TheJoboReal/self_watering_pot/pcb/main_board/main_board.png

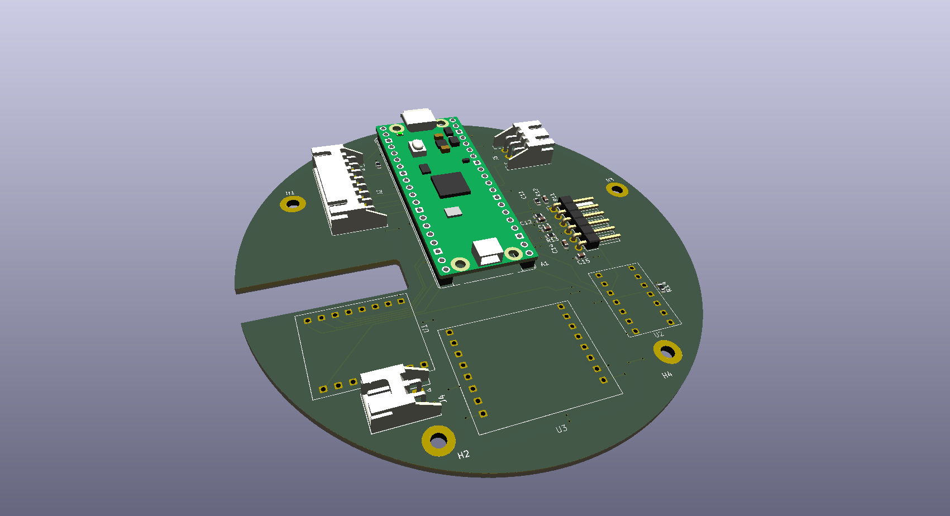
pcb/main_board/main_board.png
