TheJoboReal/self_watering_pot/report.pdf

# Low Powered Automatic Self Water Plant Pot

Kasper Bloch Mathiasen
Author
SDU
Odense, Denmark
kmath22@student.sdu.dk

Anders Stengaard
Supervisor
SDU
Odense, Denmmark
maedje@typst.app

Abstract—Maintaining plants in offices can be challenging during weekends and vacations when regular watering is not possible. This project presents the development of a low-power, low-cost automatic self-watering plant pot designed to operate for extended periods without external power. The system uses a Raspberry Pi Pico, a soil moisture sensor, a water pump, and an e-ink display. To minimize power consumption, the Pico enters dormant mode between watering cycles and is woken approximately every six hours using an external binary counter. A Run-To-Complete scheduler manages the system tasks, while a fuzzy controller is used to determine watering duration based on soil moisture measurements. The implemented components were successfully tested together on a breadboard, demonstrating the basic functionality of the system. Theoretical calculations estimate an average current consumption of 0.845 mA, corresponding to approximately three months of operation using an 1800 mAh battery. However, the estimated battery lifetime could not be experimentally verified due to damage to the battery shield during implementationMaintaining plants in offices can be challenging during weekends and vacations when regular watering is not possible. This project presents the development of a low-power, low-cost automatic self-watering plant pot designed to operate for extended periods without external power. The system uses a Raspberry Pi Pico, a soil moisture sensor, a water pump, and an e-ink display. To minimize power consumption, the Pico enters dormant mode between watering cycles and is woken approximately every six hours using an external binary counter. A Run-To-Complete scheduler manages the system tasks, while a fuzzy controller is used to determine watering duration based on soil moisture measurements. The implemented components were successfully tested together on a breadboard, demonstrating the basic functionality of the system. Theoretical calculations estimate an average current consumption of 0.845[mA], corresponding to approximately three months of operation using an 1800[mAh]. However, the estimated battery lifetime could not be experimentally verified due to damage to the battery shield during implementation. Link to the GitHub can be found here (https://github.com/TheJoboReal/self_watering_pot)

I. Introduction

We spend many hours in our offices at out workplace, this can have a negative impact on our mental health. A way to combat this is to set up plants around the office to help improve the overall mental health in that room [1]. One such plant could be a tomato plant, as it can help improve the overall mental health along with supplying a healthy snack in the form of tomatoes. However, one downside to these plants is the need to be watered daily, which can prove difficult as most office workers are not able to water them during the weekends or vacations. This could result in a work environment getting worse due to dead or rotting plants being in the office. In this individual self study project a low power, low budget self watering plant pot is developed to enable autonomous care of plants. The pot should be battery powered to ensure it is not restricted by power outlets and should be low powered and able to run without being charged for an extended period of time.

II. Related Works

Many such self watering plant pots can be bought from various online stores, such as this growing system [2] that needs to be plugged into the wall, or this more expensive smart plant pot [3] that has an integrated temperature sensor and moisture sensor. The Smart Pot does not state the battery life but is most likely not multiple months. There also exists many mechanical(passive) self watering plant pots, but many share the same limitation: The roots are constantly moist which restricts oxygen and can lead to root rot[4], while some watering systems transport water too slowly for some plants, such as tomatoes[5].
To address some of these limitations, this project focuses on developing a low-power, battery-operated self-watering system that uses soil moisture measurements to control the amount of water supplied to the plant. This allows watering to be adjusted based on the measured soil conditions while aiming to maintain a long battery life.

III. Methods

To ensure long battery life, low powered components are used in the pot. The main component of the pot is a Pico Pi running a Run-To-Complete scheduler and using dormant mode to ensure a low as possible power draw when the system is idling [6]. Thus the components used should be low power and low budget off the shelves components.

A. Components

The components used in this project is:
- HW-101 HW-moisture sensor V1.2.
- SC3101PW Vacuum diaphragm pump 3V [7].
- Binary Counter [8].
- Pico Pi 2W.
- Rechargeable Lithium Battery 1800[mAh].
- Battery Shield Wemos D1 mini.
- Motor Driver TB6612FNG.
- SD card module(planned, not integrated in hand in prototype).
- Eink Display 2.9 waveshare.

In order to use the pico pi in dormant mode an external wakeup call is needed, as the dormant mode disable the pico’s internal clock, making it unable to wake it self. To overcome this, a binary counter is used, as with the correct resistor and capacitance used with it results in the output signal going high approximately every 6 hours. This signal will then be used as the external wakeup signal for the pico pi. To avoid the counter staying high for 6 hours as well, the pico resets the counter before going to deep sleep again. This will allow the pico to draw 0.8[mA] [6] as it enters dormant mode. The pump used is a cheap 3[V] vacuum pump that draws 65[mA] to 170[mA] and will be driven with a TB6612FNG motor controller. With the pump running only at very short bursts, this should fit well in the project.
A 1800[mAh] rechargeable lithium battery is used together with a battery shield to allow for easy charging using a micro USB cable.
To enable some sort of user interface an Eink display is used to display moisture, and watering time. Eink displays are a perfect fit for this type of project as they only use power when updating the display, after which they use no power yet still show the same image.
B. Software

The software for the Pico Pi is written in C to ensure the program runs efficient when the Pico is awake. The software is build around a simple Run To Complete(RTC) scheduler to make developing modular and accessible. The functionality of the pot is divided into tasks as seen in Fig. 1. The first task after wakeup is to measure the moisture in the soil and write the result to the soil struct. The software is designed to support logging moisture measurements and watering amounts to an SD card. However, this functionality was not implemented in the final prototype due to a missing connector on the PCB and is therefore left for future development. After reading the moisture sensor output the value is inserted into a simple membership function to determine the linguistic value for the linguistic variable moisture. This is inserted into a fuzzy rule set to determine the value for watering time. Using this watering time value, the pump runs for the given amount of time. The final task before dormant mode is updating the Eink display with moisture level and watering amount.

Power on / Wake up

Initialize hardware

Initialize scheduler

Run scheduled tasks

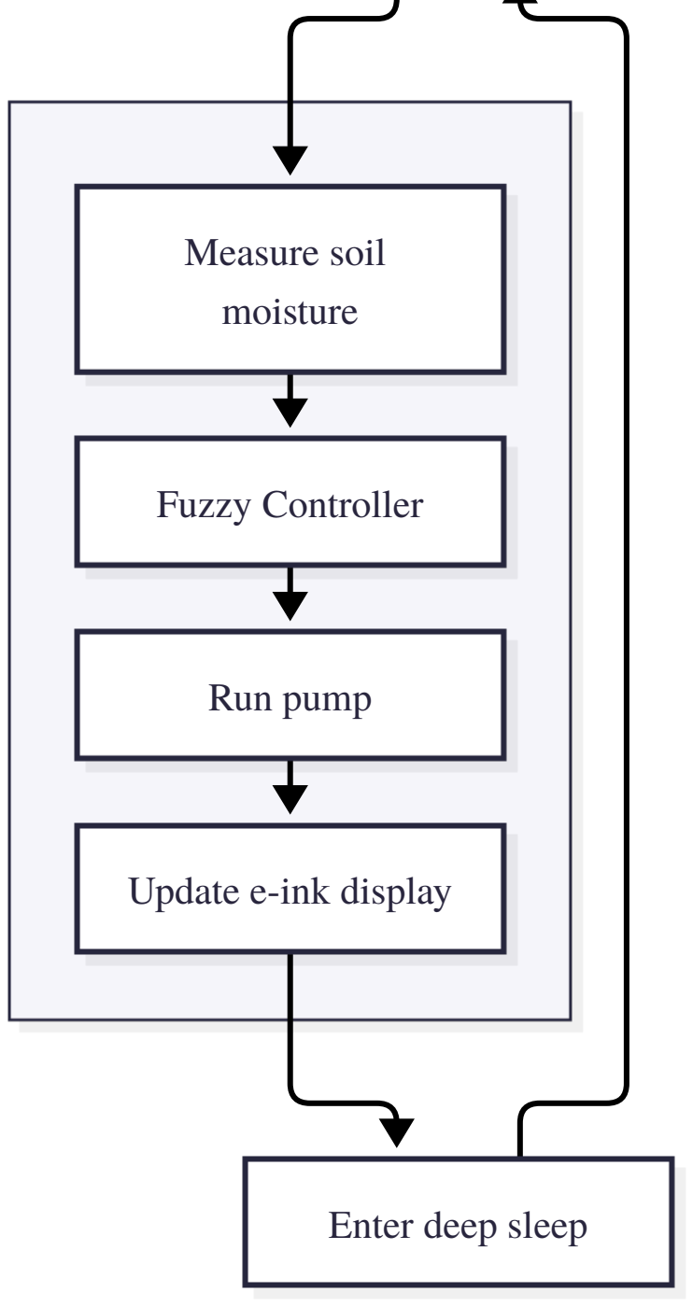
[picture p2: figure]
Measure soil; moisture; Fuzzy Controller; Run pump; Update e-ink display; Enter deep sleep

Fig. 1. Software Diagram

IV. Hardware

A. PCB Design

A PCB was designed in KiCAD to house all the components. The PCB design was sent to Aisler for manufacturing and was then soldered manually after receiving it. Small mistakes where made on the pcb design: Forgetting to route a wire for on/off for the moisture sensor, using the wrong footprint for the 4060E and forgetting to add a connector for an sd card. Though these mistakes did not invalidate the whole pcb. The 3D design can be seen in Fig. 2.

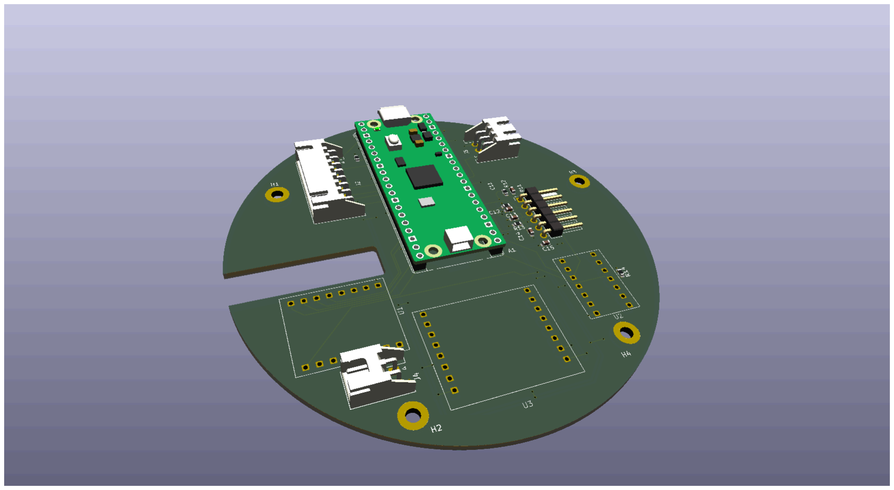
[picture p3: figure]

Fig. 2. PCB Design

B. Dormant Mode
To ensure the pi sleeps for close to 6 hours, the 4060E is used as an external wake up signal. The oscillating frequency is determined by:
1
2.2RC =

1
2.2⋅1.2[Mω]⋅1[[μF]) = 0.38[Hz]
And using output Q14 gives a frequency of: Q14 =

0.38
16384 = 0.000023[Hz]
This gives approximately a 12 hour cycle, though it should be mentioned that the 1.2[Mω] resistor is outside the specified resistance range of the 4060E, so the 6 hour low time will not be accurate.
C. Battery Life
a) 4060E:
The dynamic power consumption is determined by the formula from the datasheet[8]:
PD = CPD ⋅ V

2

CCfi + ∑(CLV
2
CC

fi
M )
where M = 2

1
, 2

2
, 2

3…2

14
a, fi =input frequency, CL = output load capacitance.
Inserting the values from our circuit:
CL = 1[pF], R = 1.2[Mω], C = 1[μ F], CPD = 40[pF], VCC = 3.3[V].
With a frequency of 0.38[Hz] and the output load of the pico pin is omitted in the dynamic formula:
40[pF] ⋅ (3.3[V])

2
⋅ 0.38[Hz] = 0.166[nW]
Thus the power draw of the 4060E when adding static and dynamic current draw is approximately 0.166[nW]
3.3[V] =
0.050[nA] + 8[μ A] ≈ 8[μ A]
b) Pump and Controller:
The max standby input current of the motor controller is rated at 1[μ A].

The pump max operating current draw is rated at 170[mA] [7]. In a test setup the pump was measured to draw approximately 100[mA] under light load. Thus 100[mA] will be used as a mean throughout the calculations.
c) Moisture sensor:
The rated operating current of the moisture sensor is 5[mA] [9]. The sensor will be turned of while in dormant mode as it is not necessary to be active while during that period.
d) Eink Display:
The eink display draws 26.4[mW]
3.3[V] ≈ 8[mA] when refreshing over 3 seconds and ≈ 0.01[μA] on standby [10].
e) Pico Pi:
The mean dormant current draw of the pico pi is 0.8[mA] according to the datasheet [6].
f) Dormant Current Draw:
Adding the standby/dormant currents up to get the total current draw when dormant:
8[μ A] + 1[μ A] + 0.01[μ A] + 0.8[mA] = 0.809[mA]. Thus a total dormant current draw of 0.809[mA] during dormant mode.
g) Active Current Draw:
Once active the pump phase draws:
IPump Phase = IPump + IPico + I4060 = 100[mA] +
25[mA] + 8[μ A] ≈ 125.008[mA]
For a maximum of 5 seconds, resulting in a maximum per pump current draw of:
QMotor Phase = 125.008[mA] ⋅

5
3600 = 0.17362[mAh]
With the moisture sensor running 2 seconds: QSensor Phase = (5[mA] + 25[mA] + 8[μ Al]) ⋅

2
3600 ≈
0.01667[mAh]
The eink refreshes for 3 seconds drawing 26.4[mW]
3.3[V] = 8[mA]
resulting in a current draw of:
QEink Pase = (8[mA] + 25[mA] + 8[μ A]) ⋅

3
3600 =
0.02751[mAh]
The phases are separated as each phase is implemented in software as a task, all running consecutively. Thus, adding all the active phases together:
Qactive = QMotor Phase + QSensor Phase + QEink Phase =
0.17362[mAh] + 0.01667[mAh] + 0.02751[mAh] = 0.21780[mAh]
h) Total Current Draw:
A full cycle of 6 hours dormant and one active cycle of 10 seconds totals the current draw at:
Dormant period without active time: tdormant = 21600[s] − 10[s] = 21590[s]
Assumed dormant current becomes:
0.80901[mA] ⋅

21590[s]
3600[s] = 4.85181[mAh]
Adding the active current draw:
4.85181[mAh] + 0.21780[mAh] = 5.06961[mAh] Meaning a full 6 hour cycle draws 5.06961[mAh]
This means that the estimated total currant draw is:
5.06961[mAh]
6[h] = 0.84494[mA], this can be seen illustrated in Fig. 3.

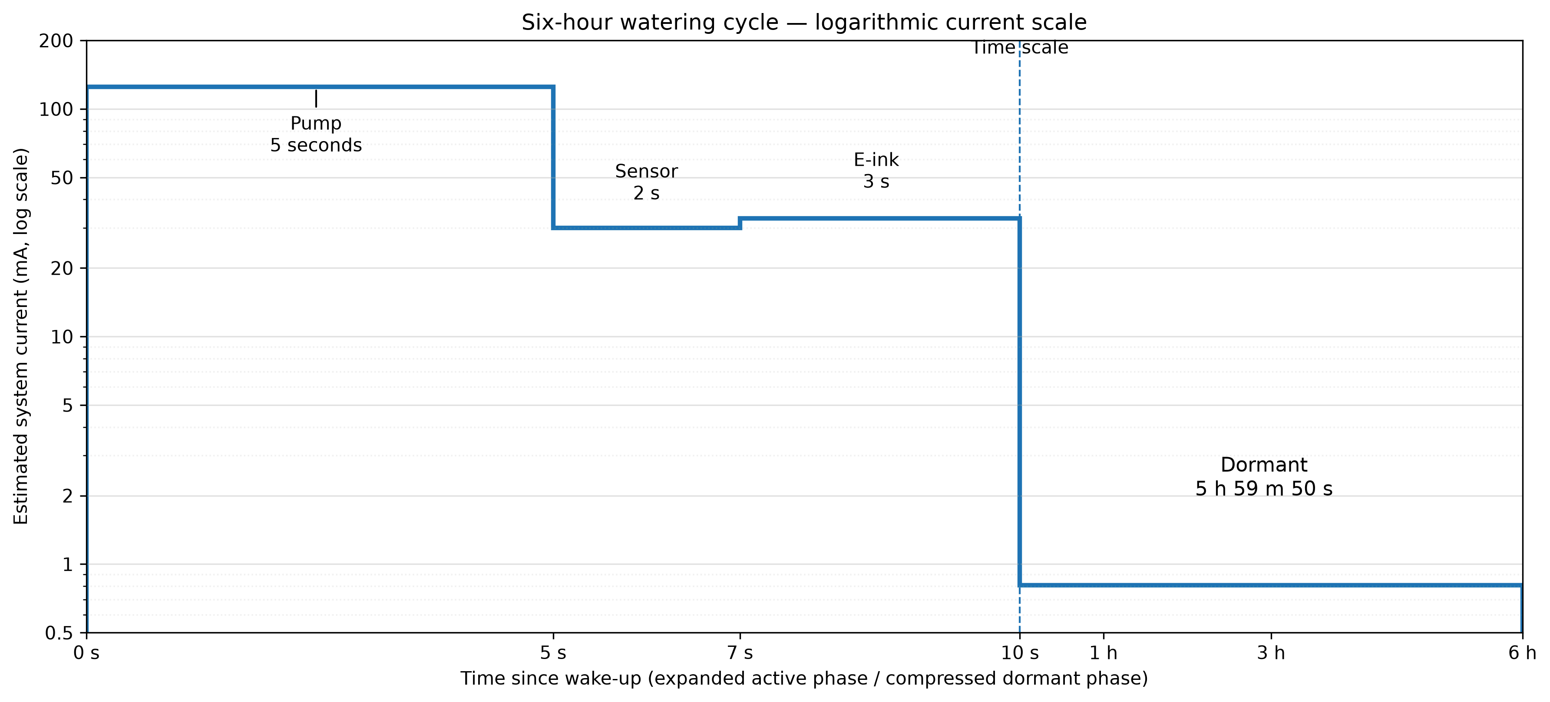
[picture p4: figure]

Fig. 3. Estimated Current Consumption

Meaning that the total battery life will be:
1800[mAh]
0.84494[mA] = 2130[h]
or:
2130[h]
24

30 = 2.96[months]. Note that this is a theoretical optimistic estimate and based on numbers from the data sheets.

V. Test

To determine if the estimated power consumption is correct the circuit will be tested by connecting the battery shield to a power supply with a multimeter in series in between. With this configuration the total current draw of both dormant and active mode can be read on the multimeter. Unfortunately the battery shield was damaged during implementation and can no longer be used, thus the test could not be performed in time for the project hand in.
All components was however tested in a breadboard and proved the functionality of the whole system.

VI. Results

All components worked during testing in a breadboard and showed all the components working as expected in unison. The estimated battery life is 3 months derived from the calculated total current draw of 0.85[mA] on a 1800[mAh] lithium battery. Real life measurements was not done in time as the battery shield was damaged when implementation the components in the pcb, hindering the real life tests.

VII. Learning Achievements

A. PCB Design

In this project i designed, ordered and soldered my first PCB. The pcb was manufactured professionally by the company Aisler. The pcb was functioning correctly but had some mistakes such as forgetting to implement a connector for an SD card and routing a wire for on/off for the moisture sensor. Though these mistakes will be fixed in the GitHub repo.

B. Low Power Embedded Projects

Through this project i went through the full pipeline of creating a low powered embedded system. Starting out was choosing the right components that fit the low powered criteria, such as using an eink display for UI and a 4060E for a low powered wake signal. Another challenge that was overcome was to fit all the components together in software and creating a simple efficient control loop.

C. Mistakes

The ordered battery shield module has outputs 5V, GND and 3.3V, but it seems that the module was damaged during implementation and now outputs 10V on the 5V pin and 0V on the 3.3V pin. This is likely due to a short circuit when inverting the encoder poles to ensure the encoder switch is active HIGH and not active LOW.

VIII. Future Work

The project will be made public on GitHub and will continue to be updated and improved upon. Firstly, the mistakes made on the hardware will be fixed and a new PCB will be designed to correct the footprint mistakes. A new battery shield will be ordered to replace the broken one.
After the errors has been fixed, a fuel gage will be added to measure the battery percentage which will be displayed on the eink display. An SD card module will also be added to enable logging during operation and can enable plotting of various data on the eink display.

IX. Conclusion

In this project, a low-power automatic self-watering plant pot was developed using a Raspberry Pi Pico, a soil moisture sensor, a water pump, and an e-ink display. To reduce power consumption, the Pico uses dormant mode together with an external binary counter to wake the system approximately every six hours. The software was developed using a simple Run-To-Complete scheduler to manage the different tasks of the system.
The implemented components was successfully tested together on a breadboard, demonstrating the basic functionality of the self-watering system. Based on theoretical calculations using component datasheets, the system has an estimated average current consumption of 0.845[mA], resulting in a battery life of approximately three months with an 1800[mAh] battery. However, this estimate could not be verified through physical measurements due to damage to the battery shield during implementation.
Although the project encountered some hardware design mistakes, it provided valuable experience in designing PCBs, selecting low-power components, and developing embedded software. Further improvements are needed before the system can be considered fully completed, including correcting the PCB design, implementing SD card logging, and verifying the actual power consumption.
X. Acknowlegdement

LLM’s was used in the process or correcting the report. The plant pot CAD design is derived from the work of Martin [11].

References

[1] C. Hall and M. Knuth, “An update of the literature supporting the wellbeing benefits of plants: A review of the emotional and mental health benefits of plants,” Journal of Environmental Horticulture, vol. 37, no. 1, pp. 30–38, 2019.
[2] “Indoor Garden Hydroponics Growing System,” [Online]. Available: https://www.amazon.com/Indoor-Garden-Hydroponic-Growing-System/dp/B0B6BB4TVC (https://www.amazon.com/Indoor-Garden-Hydroponic-Growing-System/dp/B0B6BB4TVC)
[3] | “Pink | Smart | Plant | Pot | with | SelfWatering | Planter,” | [On-
line]. Available: https://www.fruugo.dk/lyserod-smart-plantepotte-medselvvandende-plantepotte-fugtighedssensor-og-temperaturovervagning-til-indendorsbrug/p-452581288-954266539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 MMXDA (https://www.fruugo.dk/lyserod-smart-plantepotte-med-selvvandende-plantepotte-fugtighedssensor-og-temperaturovervagning-til-indendorsbrug/p-452581288-954266539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)
[4] | “Root Rot,” [Online]. | Available: https://extension.wsu.edu/pnw-
gardeners-handbook/chapter-14-houseplants/ (https://extension.wsu.edu/pnw-gardeners-handbook/chapter-14-houseplants/)
[5] “A Semi-Systematic Review of Capillary Irrigation,” [Online]. Available: https://www.mdpi.com/2311-7524/4/3/23
[6] “Pico Pi dormant mode++: Pico pi documentation,” [Online]. Available: https://pip-assets.raspberrypi.com/categories/610-raspberrypi-pico/documents/RP-008307-DS-2-pico-datasheet.pdf (https://pip-assets.raspberrypi.com/categories/610-raspberry-pi-pico/documents/RP-008307-DS-2-pico-datasheet.pdf)
[7] “Vacum pump,” [Online]. Available: https://www.laskakit.cz/en/sc3101pw-vakuove-membranove-cerpadlo-3v/ (https://www.laskakit.cz/en/sc3101pw-vakuove-membranove-cerpadlo-3v/)
[8] | “Binary Counter,” [Online]. | Available: https://www.digikey.dk/en/
products/detail/texas-instruments/SN74HC4060DBR/1571132 (https://www.digikey.dk/en/products/detail/texas-instruments/SN74HC4060DBR/1571132)
[9] | “Moisture | sensor | Datasheet,” | [Online]. | Available: | https://
docs.sunfounder.com/projects/esp32-starter-kit/en/latest/components/ component_moisture_module.html (https://docs.sunfounder.com/projects/esp32-starter-kit/en/latest/components/component_moisture_module.html)
[10] “Eink Display,” [Online]. Available: https://www.waveshare.com/2.9 inch-e-paper-module.htm (https://www.waveshare.com/2.9inch-e-paper-module.htm)
[11] “Plant pot inspiration,” [Online]. Available: https://www.thingiverse.com/thing:4921885 (https://www.thingiverse.com/thing:4921885)
