TheJoboReal/self_watering_pot/plots/current_draw_6h.png

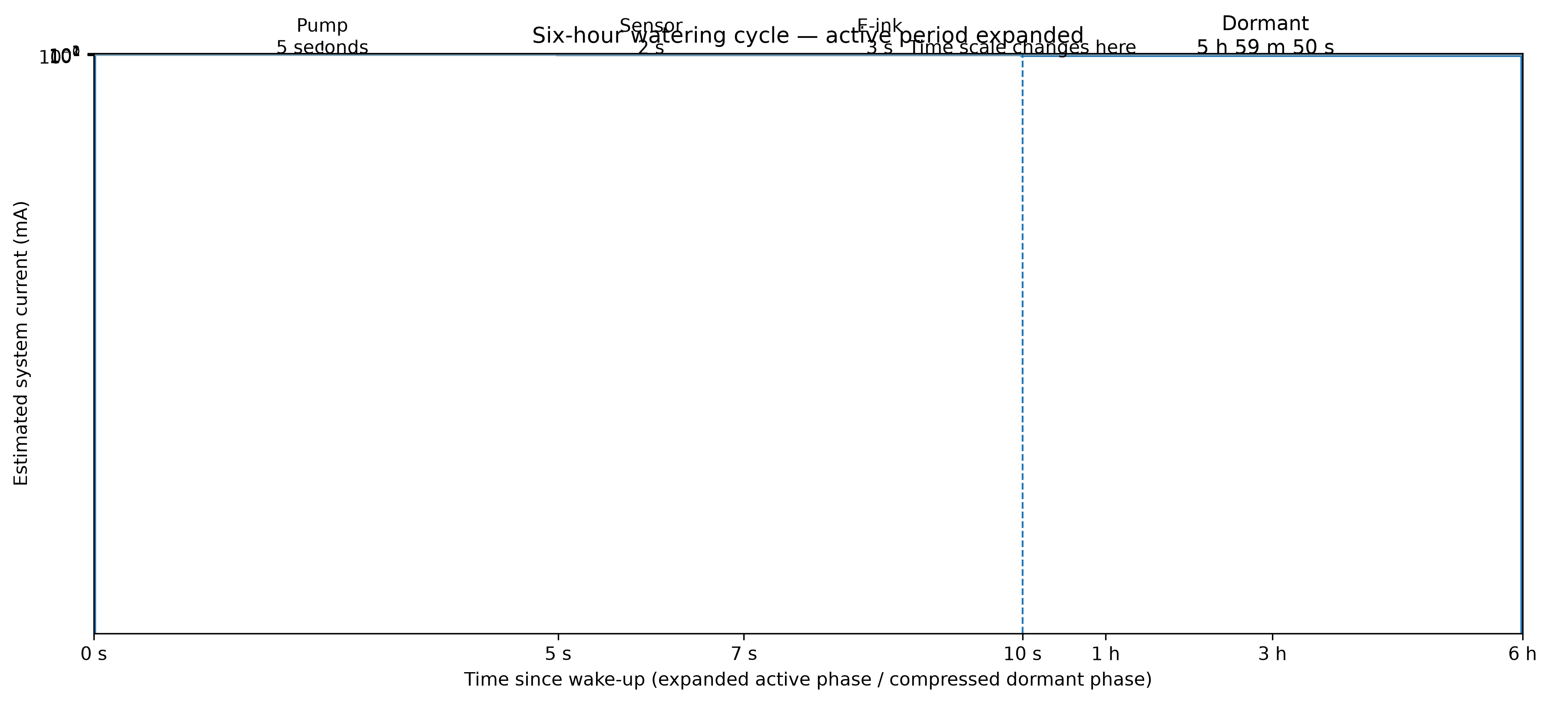
plots/current_draw_6h.png
