TheJoboReal/self_watering_pot/pcb/main_board/main_board.csv

Reference | Qty | Value | DNP | Footprint | JLCPCB Part
C11,C12,C13,C14,C15 | 5 | 47pF |  | Capacitor_SMD:C_0603_1608Metric | C1567
R11,R12,R13,R14,R15 | 5 | 1k |  | Resistor_SMD:R_0603_1608Metric | C173557
