TheJoboReal/self_watering_pot/pcb/main_board/main_board.step

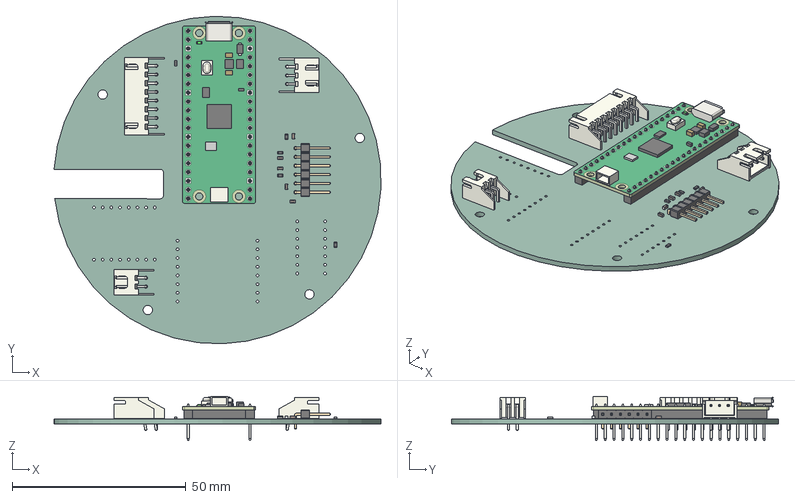
[picture p6: CAD file, 2026-10-04]
pcb/main_board/main_board.step
94.1 x 94.2 x 12.8 mm
JST_S2B_XH_A
R_0603_1608Metric x 5
C_0603_1608Metric x 5
PinHeader_1x06_P254mm_Horizontal
JST_S3B_XH_A
JST_S8B_XH_A
RaspberryPi_Pico_H_Module_KiCad
RaspberryPi_Pico_Header_DIP-40_H2.54mm_KiCad
main_board_PCB
