TheJoboReal/self_watering_pot/3D/Plant_pot/files/Housing_Bottom.stl

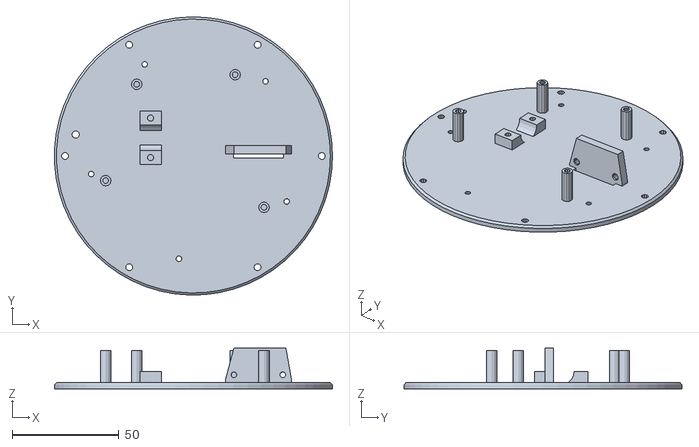
[picture p7: CAD file, 2026-11-06]
3D/Plant_pot/files/Housing_Bottom.stl
129.9 x 130.0 x 19.0
