TheJoboReal/self_watering_pot/3D/Plant_pot/files/stl/bottom_plate.stl

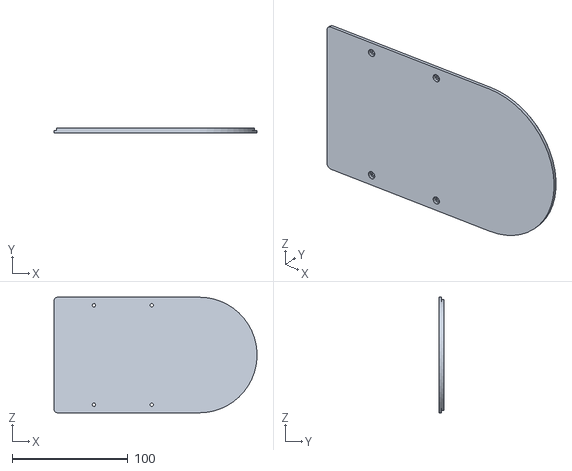
[picture p8: CAD file, 2026-10-27]
3D/Plant_pot/files/stl/bottom_plate.stl
175.5 x 4.00 x 100.0
