TheJoboReal/self_watering_pot/3D/pot.FCStd

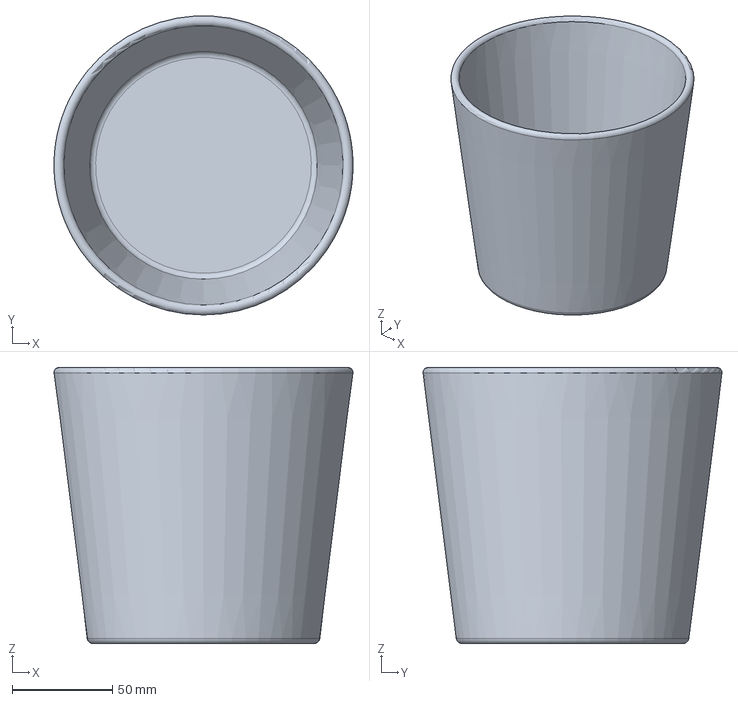
[picture p9: CAD file, 2026-09-06]
3D/pot.FCStd
148.9 x 148.9 x 137.5 mm
