TheJoboReal/self_watering_pot/3D/Plant_pot/files/pump_mount.stl

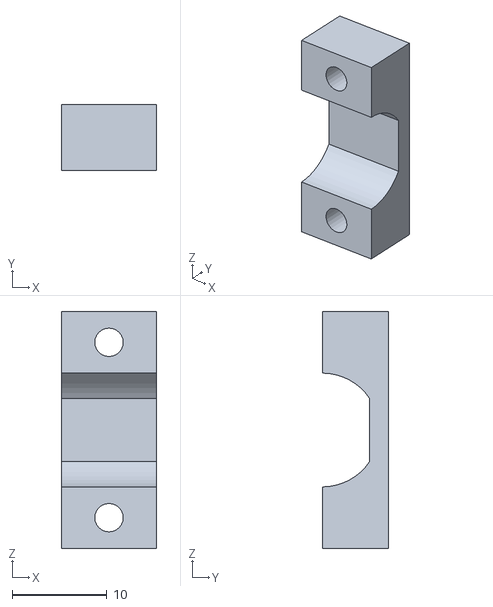
[picture p10: CAD file, 2026-11-06]
3D/Plant_pot/files/pump_mount.stl
10.0 x 7.00 x 25.0
