TheJoboReal/self_watering_pot/3D/Plant_pot/files/stl/Housing_Outer.stl

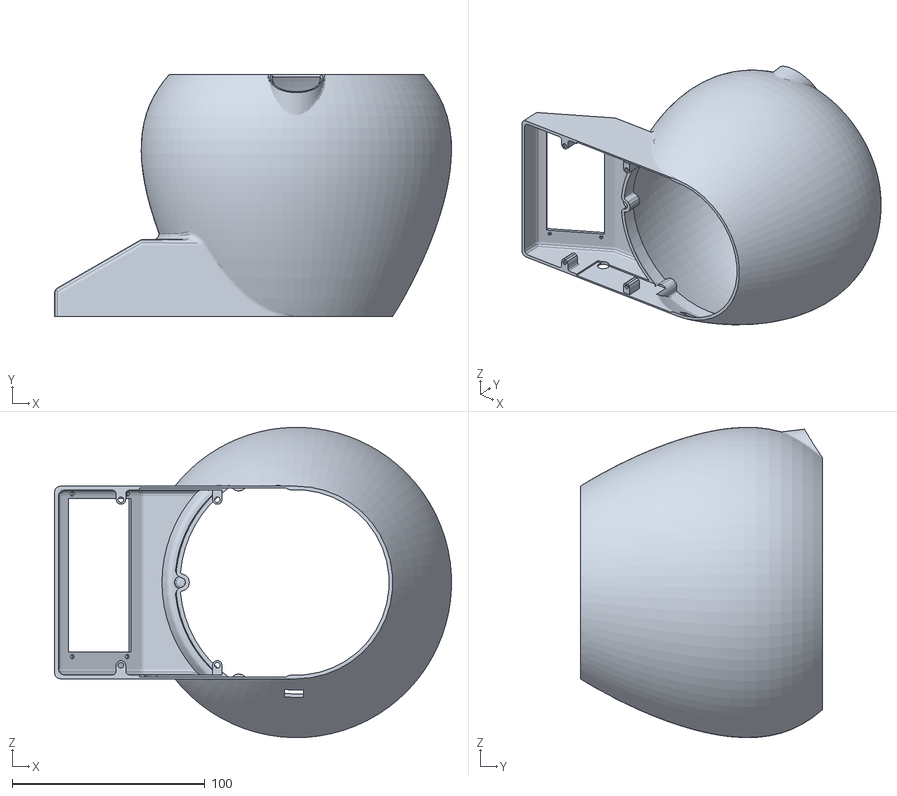
[picture p11: CAD file, 2026-10-27]
3D/Plant_pot/files/stl/Housing_Outer.stl
206.1 x 125.8 x 161.1
