TheJoboReal/self_watering_pot/3D/Plant_pot/files/2.9inch e-Paper Module bw v2.STEP

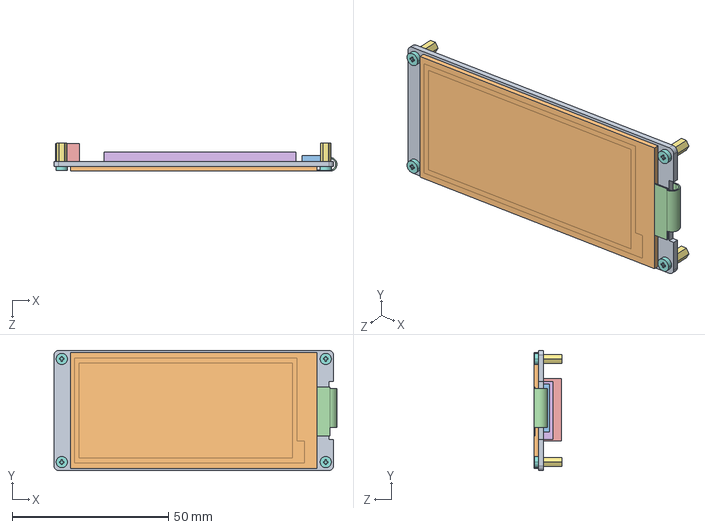
[picture p12: CAD file, 2026-10-09]
3D/Plant_pot/files/2.9inch e-Paper Module bw v2.STEP
90.6 x 38.5 x 9.10 mm
