TheJoboReal/self_watering_pot/3D/Plant_pot/files/Housing_Inside.stl

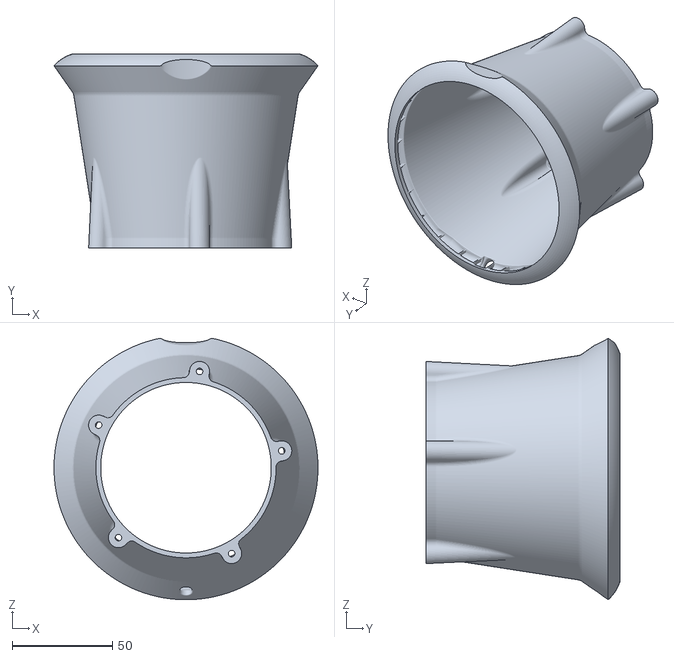
[picture p13: CAD file, 2026-10-09]
3D/Plant_pot/files/Housing_Inside.stl
131.7 x 97.0 x 130.4
