TheJoboReal/self_watering_pot/3D/Plant_pot/files/Battery_Mount.stl

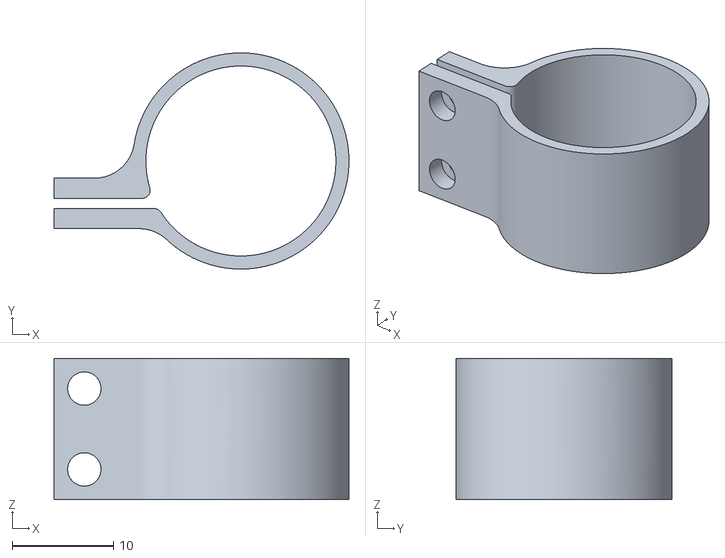
[picture p14: CAD file, 2026-10-09]
3D/Plant_pot/files/Battery_Mount.stl
29.2 x 21.4 x 14.0
