TheJoboReal/self_watering_pot/3D/Plant_pot/files/Water_Pump_Mount.stl

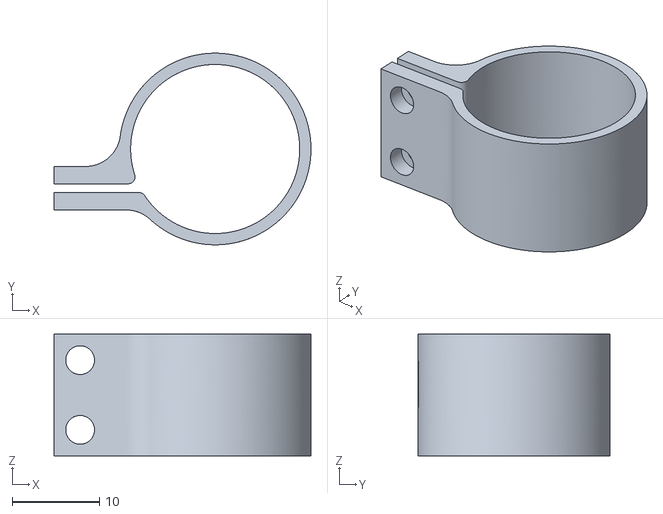
[picture p15: CAD file, 2026-10-09]
3D/Plant_pot/files/Water_Pump_Mount.stl
29.5 x 22.0 x 14.0
