TheJoboReal/self_watering_pot/3D/Plant_pot/files/Housing_Outside.stl

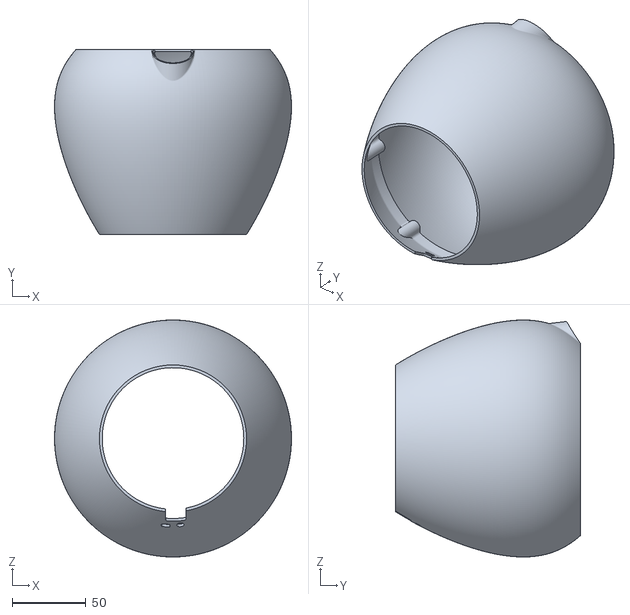
[picture p16: CAD file, 2026-10-09]
3D/Plant_pot/files/Housing_Outside.stl
161.2 x 125.8 x 161.1
