TheJoboReal/self_watering_pot/3D/Plant_pot/files/Water_Level_Sensor_Mount.stl

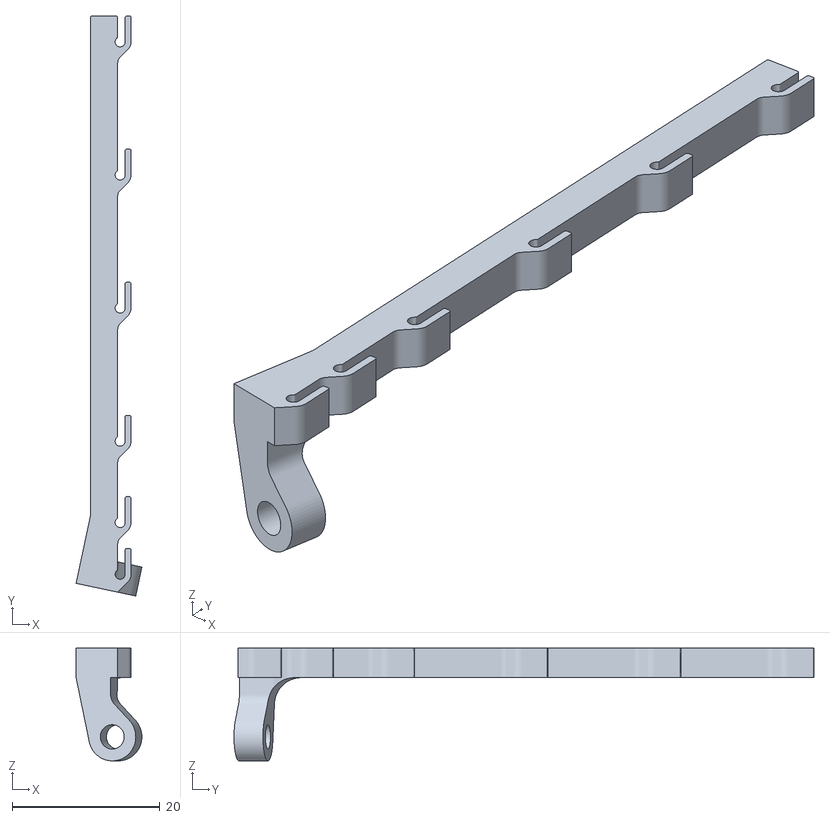
[picture p17: CAD file, 2026-10-09]
3D/Plant_pot/files/Water_Level_Sensor_Mount.stl
8.90 x 78.4 x 15.2
