TheJoboReal/self_watering_pot/(list of files, cad)

Other CAD files:
3D/Plant_pot/files/inner_pot.stl
3D/Plant_pot/files/2.9inch e-Paper Module bw v2/2.9inch e-Paper Module bw v2.ipt
3D/Plant_pot/files/Assembly_Flaura.iam
3D/Plant_pot/files/Battery_Mount.ipt
3D/Plant_pot/files/Dummy_Capacitive_Soil_Sensor.ipt
3D/Plant_pot/files/Dummy_Circuit_Board.ipt
3D/Plant_pot/files/Dummy_ESP32_WEMOS_LOLIN32.ipt
3D/Plant_pot/files/Dummy_LiPo_Battery_18650.ipt
3D/Plant_pot/files/Dummy_Water_Pump.ipt
3D/Plant_pot/files/Housing_Bottom.ipt
3D/Plant_pot/files/Housing_Inner_Outer.ipt
3D/Plant_pot/files/OldVersions/Assembly_Flaura.0084.iam
3D/Plant_pot/files/OldVersions/Bottom_plate.0008.ipt
3D/Plant_pot/files/OldVersions/Housing_Bottom.0038.ipt
3D/Plant_pot/files/OldVersions/Housing_Inner_Outer.0029.ipt
3D/Plant_pot/files/OldVersions/Housing_Inner_Outer.0031.ipt
3D/Plant_pot/files/OldVersions/pump_mount.0001.ipt
3D/Plant_pot/files/Part1.ipt
3D/Plant_pot/files/Water_Level_Sensor_Mount.ipt
3D/Plant_pot/files/Water_Pump_Mount.ipt
3D/Plant_pot/files/bottom_plate.ipt
3D/Plant_pot/files/inner_shell.ipt
3D/Plant_pot/files/outer_shell.ipt
3D/Plant_pot/files/pump_mount.ipt
3D/Plant_pot/files/stl/Housing_Bottom.stl
3D/Plant_pot/files/stl/inner_pot.stl
pcb/main_board/main_board/main_board.ipt
