TheJoboReal/self_watering_pot/code/build/picotool/tmp/picotoolBuild-cfgcmd.txt

cmd='/run/current-system/sw/bin/cmake;--no-warn-unused-cli;-DCMAKE_MAKE_PROGRAM:FILEPATH=/run/current-system/sw/bin/make;-DPICO_SDK_PATH:FILEPATH=/home/kasper/.pico-sdk;-DPICOTOOL_NO_LIBUSB=1;-DPICOTOOL_FLAT_INSTALL=1;-DCMAKE_INSTALL_PREFIX=/home/kasper/Documents/Projects/self_watering_pot/code/build/_deps;-DCMAKE_RULE_MESSAGES=OFF;-DCMAKE_INSTALL_MESSAGE=NEVER;-GUnix Makefiles;-S;<SOURCE_DIR><SOURCE_SUBDIR>;-B;<BINARY_DIR>'
