TheJoboReal/self_watering_pot/code/build/_deps/picotool-subbuild/picotool-populate-prefix/src/picotool-populate-stamp/picotool-populate-gitinfo.txt

# This is a generated file and its contents are an internal implementation detail.
# The download step will be re-executed if anything in this file changes.
# No other meaning or use of this file is supported.

method=git
command=/run/current-system/sw/bin/cmake;-DCMAKE_MESSAGE_LOG_LEVEL=VERBOSE;-P;/home/kasper/Documents/Projects/self_watering_pot/code/build/_deps/picotool-subbuild/picotool-populate-prefix/tmp/picotool-populate-gitclone.cmake
source_dir=/home/kasper/Documents/Projects/self_watering_pot/code/build/_deps/picotool-src
work_dir=/home/kasper/Documents/Projects/self_watering_pot/code/build/_deps
repository=https://github.com/raspberrypi/picotool.git
remote=origin
init_submodules=TRUE
recurse_submodules=--recursive
submodules=
CMP0097=NEW
