TheJoboReal/self_watering_pot/code/build/pico-sdk/src/rp2_common/pico_cyw43_driver/pioasm/tmp/pioasmBuild-cfgcmd.txt

cmd='/run/current-system/sw/bin/cmake;--no-warn-unused-cli;-DCMAKE_MAKE_PROGRAM:FILEPATH=/run/current-system/sw/bin/make;-DPIOASM_FLAT_INSTALL=1;-DCMAKE_INSTALL_PREFIX=/home/kasper/Documents/Projects/self_watering_pot/code/build/pioasm-install;-DCMAKE_RULE_MESSAGES=OFF;-DCMAKE_INSTALL_MESSAGE=NEVER;-GUnix Makefiles;-C<TMP_DIR>/pioasmBuild-cache-$<CONFIG>.cmake;-S;<SOURCE_DIR><SOURCE_SUBDIR>;-B;<BINARY_DIR>'
