TheJoboReal/self_watering_pot/pcb/main_board/main_board.kicad_pcb

## KiCad design pcb/main_board/main_board.kicad_pcb (2026-11-06)

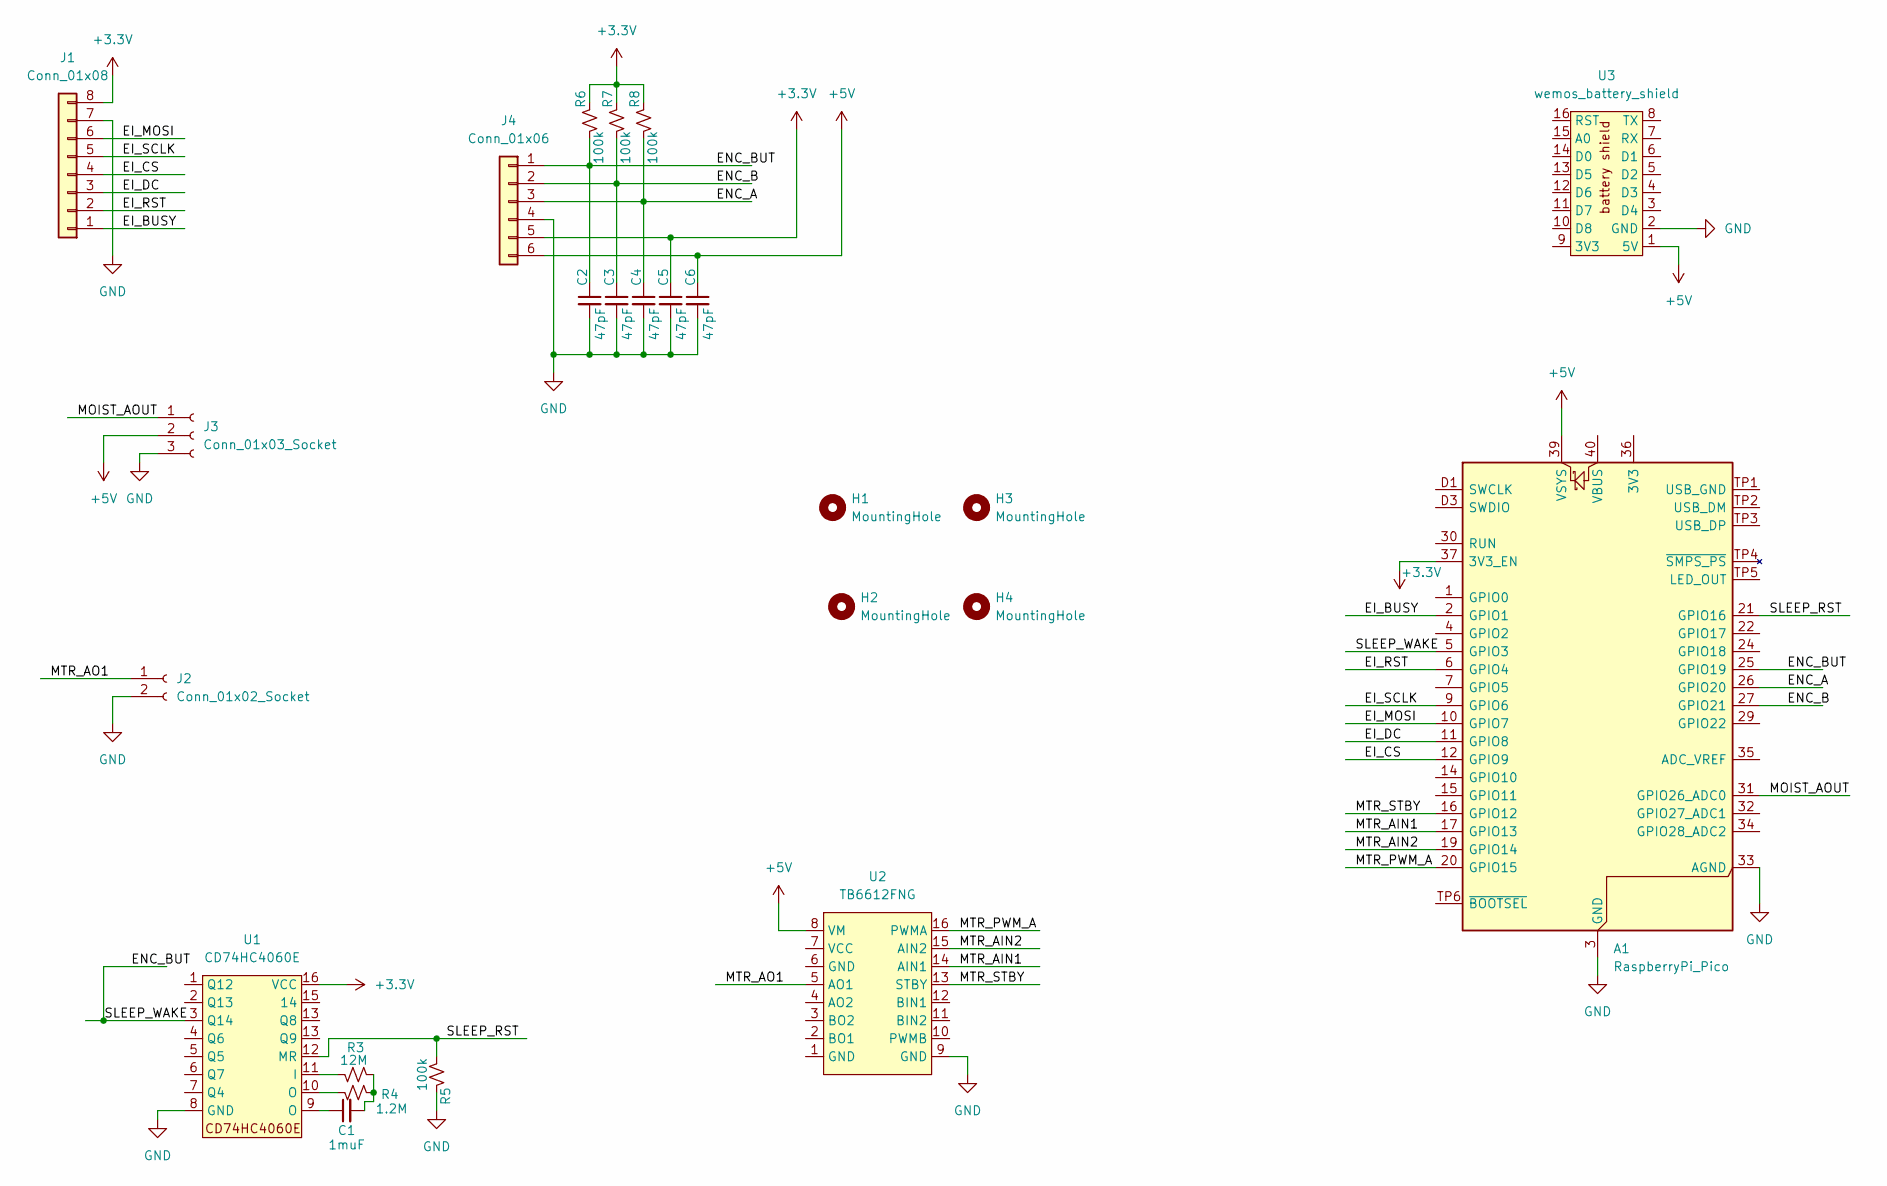
[picture p18: schematic main_board.kicad_sch]

Parts:
A1: RaspberryPi_Pico; RaspberryPi_Pico_Common_THT
C1: 1muF; C_0603_1608Metric
C2, C3, C4, C5, C6: 47pF; C_0603_1608Metric
H1, H2, H3, H4: MountingHole; MountingHole_2.7mm_Pad_TopBottom
J1: Conn_01x08; JST_XH_S8B-XH-A_1x08_P2.50mm_Horizontal
J2: Conn_01x02_Socket; JST_XH_S2B-XH-A_1x02_P2.50mm_Horizontal
J3: Conn_01x03_Socket; JST_XH_S3B-XH-A_1x03_P2.50mm_Horizontal
J4: Conn_01x06; PinHeader_1x06_P2.54mm_Horizontal
R3: 12M; R_0603_1608Metric
R4: 1.2M; R_0603_1608Metric
R5, R6, R7, R8: 100k; R_0603_1608Metric
U1: CD74HC4060E
U2: TB6612FNG
U3: wemos_battery_shield; Untitled

Connections:
+3.3V: A1.37 (3V3_EN), C5.1, J1.8, J4.5, R6.1, R7.1, R8.1, U1.16 (VCC)
+5V: A1.39 (VSYS), C6.1, J3.2, J4.6, U2.8 (VM), U3.1 (5V)
/EI_BUSY: A1.2 (GPIO1), J1.1
/EI_CS: A1.12 (GPIO9), J1.4
/EI_DC: A1.11 (GPIO8), J1.3
/EI_MOSI: A1.10 (GPIO7), J1.6
/EI_RST: A1.6 (GPIO4), J1.2
/EI_SCLK: A1.9 (GPIO6), J1.5
/ENC_A: A1.26 (GPIO20), C4.1, J4.3, R8.2
/ENC_B: A1.27 (GPIO21), C3.1, J4.2, R7.2
/ENC_BUT: A1.5 (GPIO3), A1.25 (GPIO19), C2.1, J4.1, R6.2, U1.3 (Q14)
/MOIST_AOUT: A1.31 (GPIO26_ADC0), J3.1
/MTR_AIN1: A1.17 (GPIO13), U2.14 (AIN1)
/MTR_AIN2: A1.19 (GPIO14), U2.15 (AIN2)
/MTR_AO1: J2.1, U2.5 (AO1)
/MTR_PWM_A: A1.20 (GPIO15), U2.16 (PWMA)
/MTR_STBY: A1.16 (GPIO12), U2.13 (STBY)
/SLEEP_RST: A1.21 (GPIO16), R5.2, U1.12 (MR)
GND: A1.3 (GND), A1.8 (GND), A1.13 (GND), A1.18 (GND), A1.23 (GND), A1.28 (GND), A1.33 (AGND), A1.38 (GND), A1.D2 (GND), C2.2, C3.2, C4.2, C5.2, C6.2, J1.7, J2.2, J3.3, J4.4, R5.1, U1.8 (GND), U2.9 (GND), U3.2 (GND)
unnamed: C1.1, U1.9 (O)
unnamed: C1.2, R3.1, R4.1
unnamed: R4.2, U1.10 (O)
unnamed: R3.2, U1.11 (I)

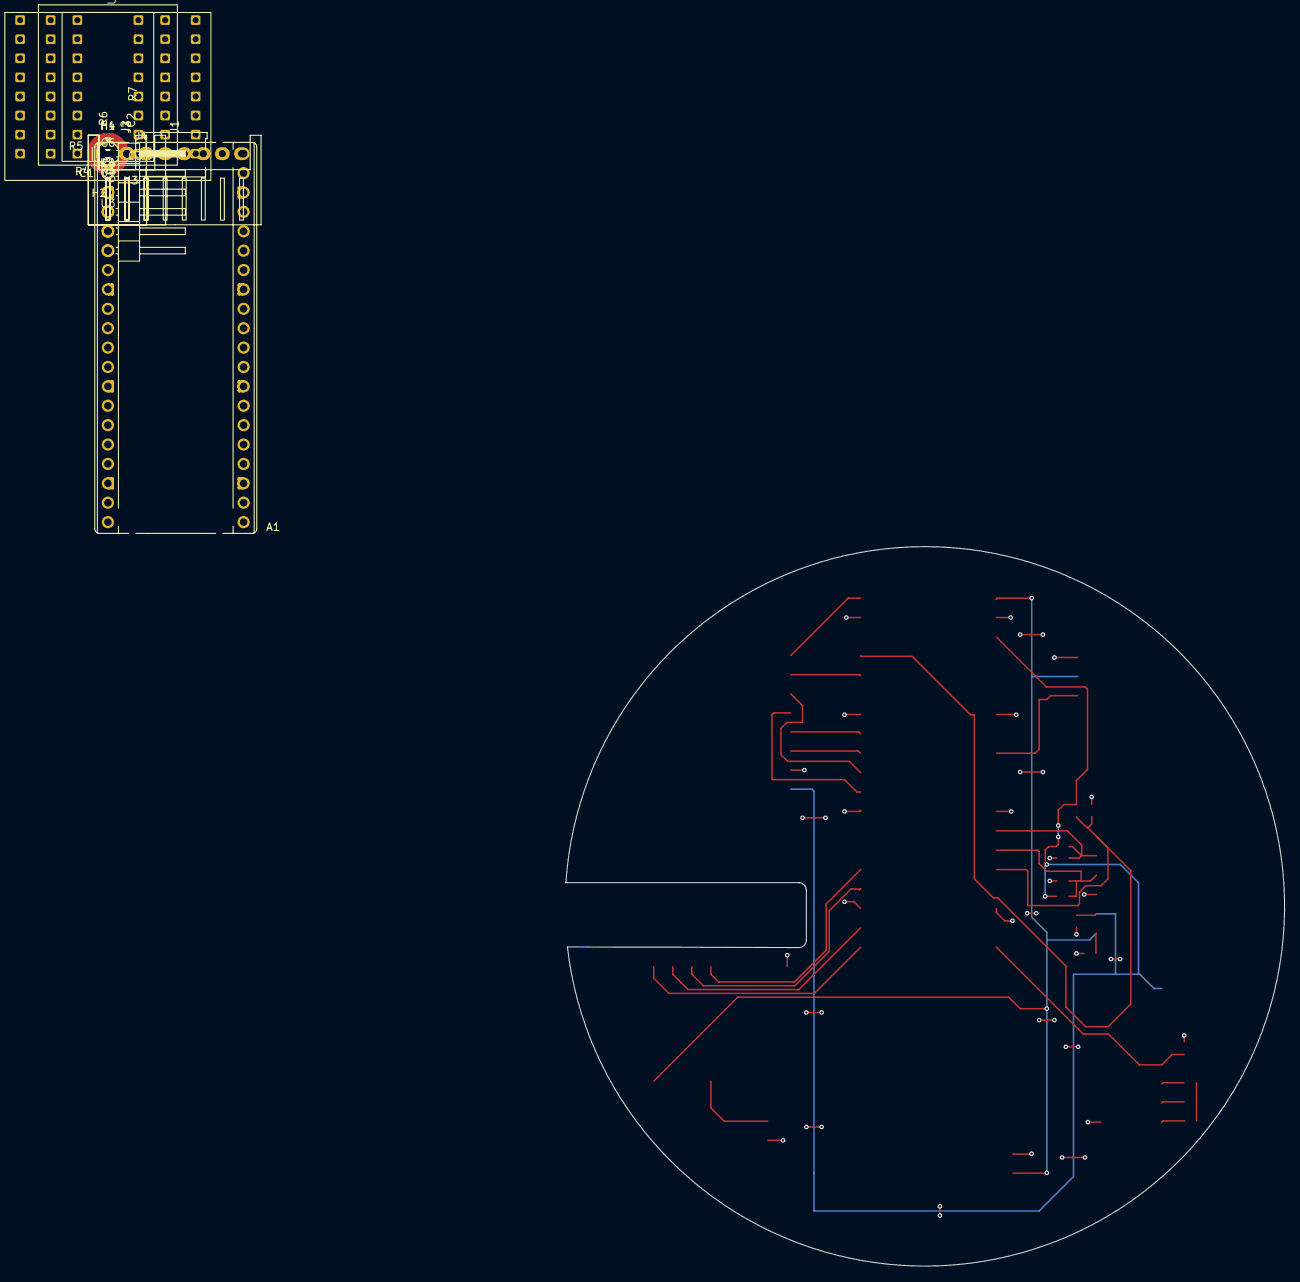
[picture p19: board pcb/main_board/main_board.kicad_pcb from above]

Board: 2 copper layers, 94.1 x 94.2 mm, 24 parts (0 on the bottom side), 23 nets.
