TheJoboReal/self_watering_pot/pcb/main_board/_restore_backup_2026-10-03T14-03-02-734/main_board.kicad_pcb

## KiCad design pcb/main_board/_restore_backup_2026-10-03T14-03-02-734/main_board.kicad_pcb (2026-10-03)

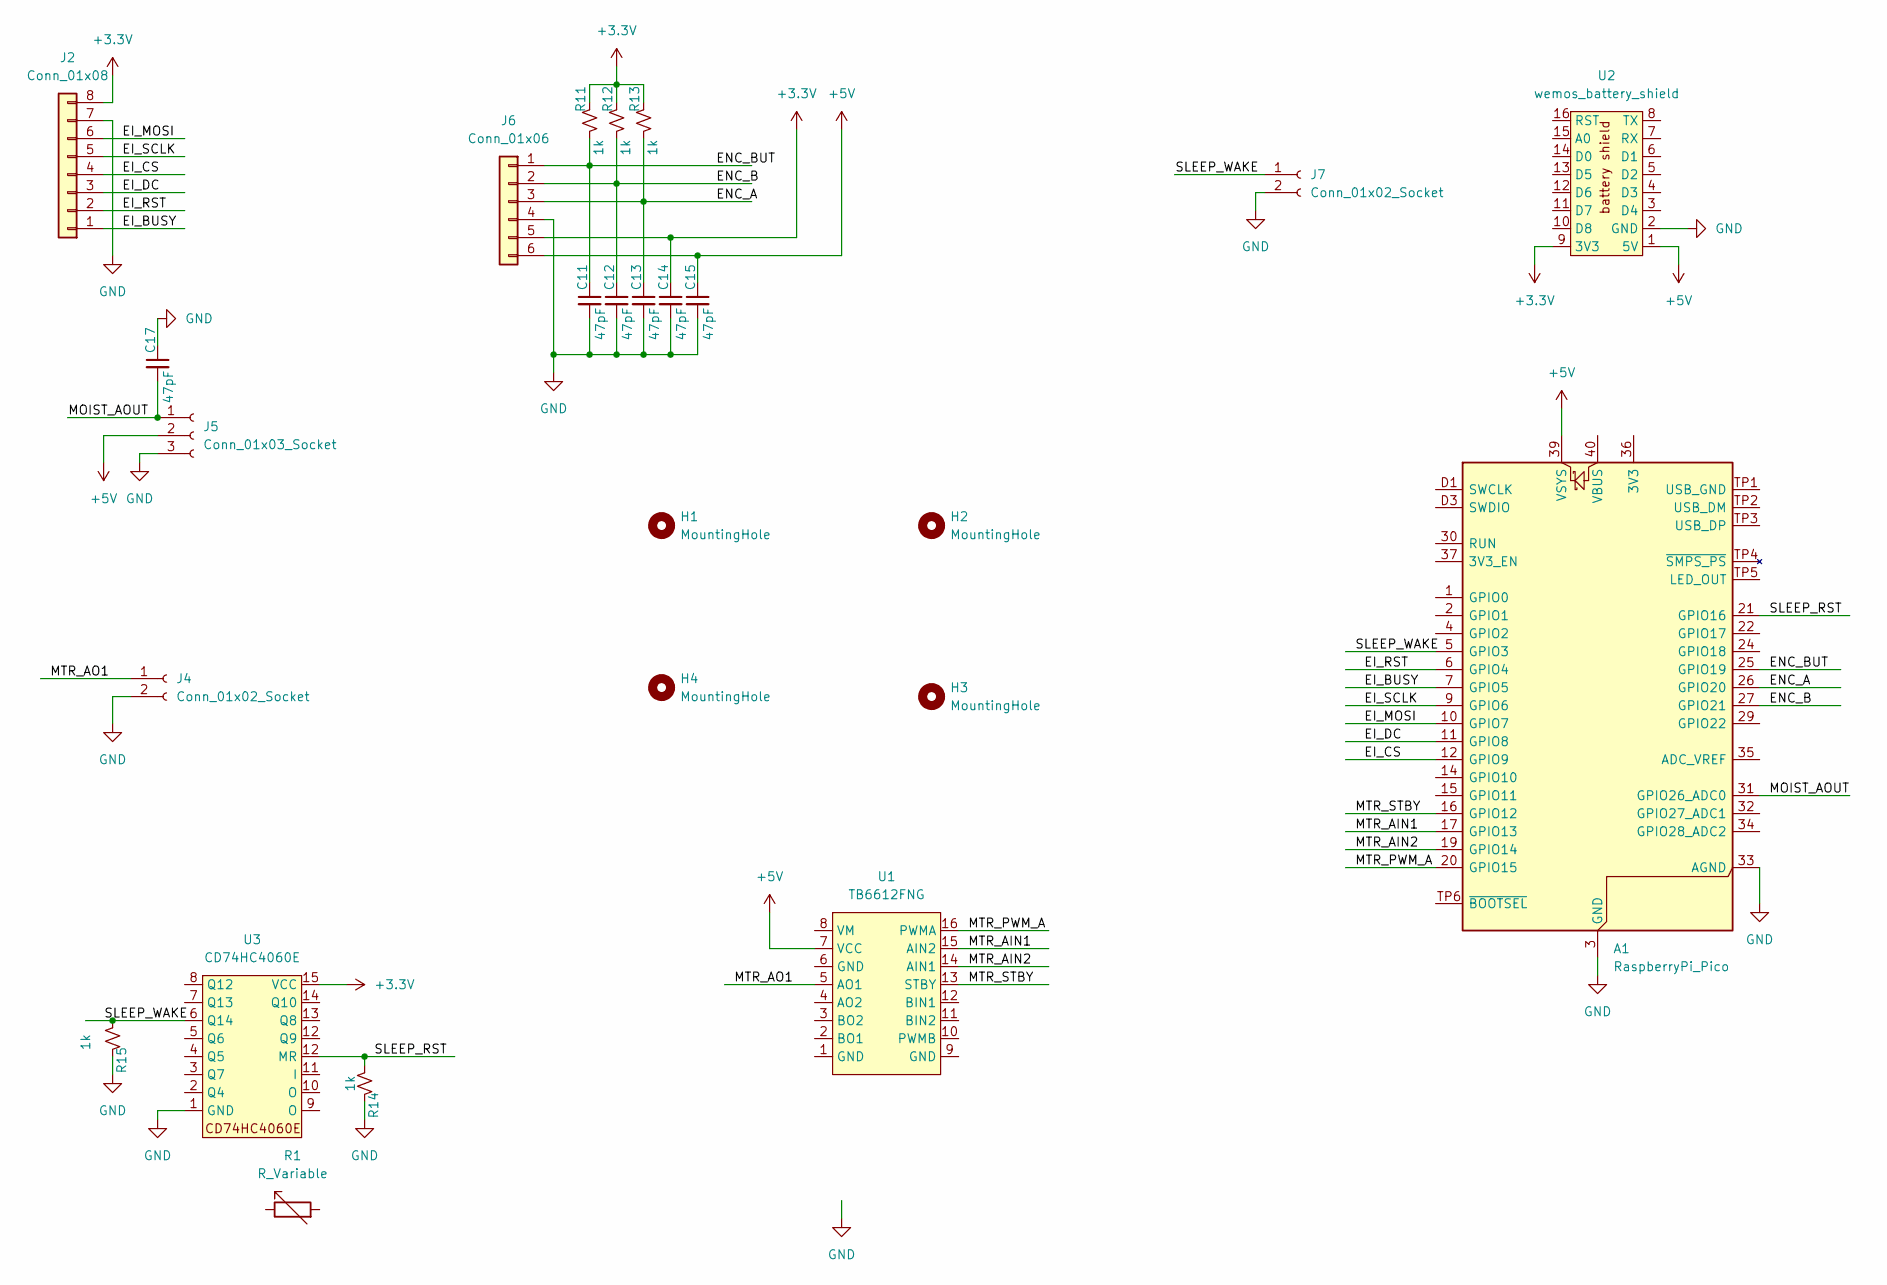
[picture p20: schematic main_board.kicad_sch]

Parts:
A1: RaspberryPi_Pico; RaspberryPi_Pico_Common_THT
C11, C12, C13, C14, C15, C17: 47pF; C_0603_1608Metric
H1, H2, H3, H4: MountingHole; MountingHole_2.5mm_Pad_TopBottom
J2: Conn_01x08; JST_XH_S8B-XH-A_1x08_P2.50mm_Horizontal
J4, J7: Conn_01x02_Socket; JST_XH_S2B-XH-A_1x02_P2.50mm_Horizontal
J5: Conn_01x03_Socket; JST_XH_S3B-XH-A_1x03_P2.50mm_Horizontal
J6: Conn_01x06; PinHeader_1x06_P2.54mm_Horizontal
R1: R_Variable
R11, R12, R13, R14, R15: 1k; R_0603_1608Metric
U1: TB6612FNG
U2: wemos_battery_shield; Untitled
U3: CD74HC4060E

Connections:
+3.3V: C14.1, J2.8, J6.5, R11.1, R12.1, R13.1, U2.9 (3V3), U3.15 (VCC)
+5V: A1.39 (VSYS), C15.1, J5.2, J6.6, U1.7 (VCC), U2.1 (5V)
/EI_BUSY: A1.7 (GPIO5), J2.1
/EI_CS: A1.12 (GPIO9), J2.4
/EI_DC: A1.11 (GPIO8), J2.3
/EI_MOSI: A1.10 (GPIO7), J2.6
/EI_RST: A1.6 (GPIO4), J2.2
/EI_SCLK: A1.9 (GPIO6), J2.5
/ENC_A: A1.26 (GPIO20), C13.1, J6.3, R13.2
/ENC_B: A1.27 (GPIO21), C12.1, J6.2, R12.2
/ENC_BUT: A1.25 (GPIO19), C11.1, J6.1, R11.2
/MOIST_AOUT: A1.31 (GPIO26_ADC0), C17.2, J5.1
/MTR_AIN1: A1.17 (GPIO13), U1.15 (AIN2)
/MTR_AIN2: A1.19 (GPIO14), U1.14 (AIN1)
/MTR_AO1: J4.1, U1.5 (AO1)
/MTR_PWM_A: A1.20 (GPIO15), U1.16 (PWMA)
/MTR_STBY: A1.16 (GPIO12), U1.13 (STBY)
/SLEEP_RST: A1.21 (GPIO16), R14.2, U3.12 (MR)
/SLEEP_WAKE: A1.5 (GPIO3), J7.1, R15.2, U3.6 (Q14)
GND: A1.3 (GND), A1.8 (GND), A1.13 (GND), A1.18 (GND), A1.23 (GND), A1.28 (GND), A1.33 (AGND), A1.38 (GND), A1.D2 (GND), C11.2, C12.2, C13.2, C14.2, C15.2, C17.1, J2.7, J4.2, J5.3, J6.4, J7.2, R14.1, R15.1, U2.2 (GND), U3.1 (GND)

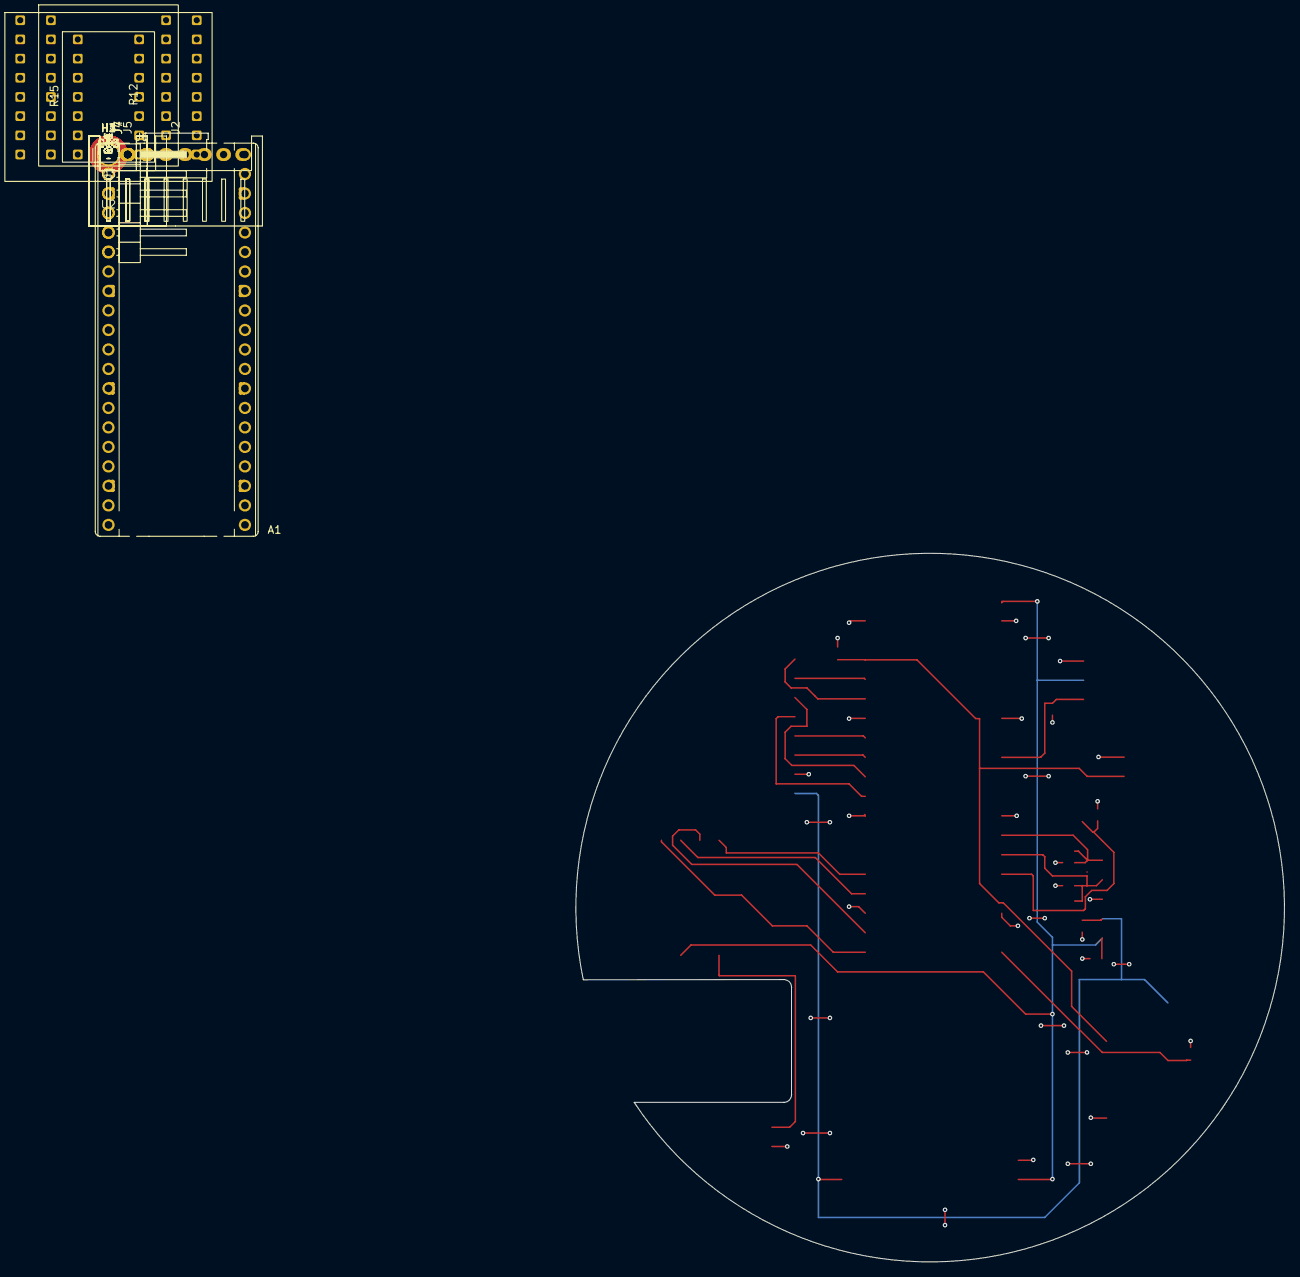
[picture p21: board pcb/main_board/_restore_backup_2026-10-03T14-03-02-734/main_board.kic… from above]

Board: 2 copper layers, 92.3 x 92.3 mm, 24 parts (0 on the bottom side), 20 nets.
