TheJoboReal/self_watering_pot/pcb/main_board/_restore_backup_2026-09-27T20-24-21-155/main_board.kicad_pcb

## KiCad design pcb/main_board/_restore_backup_2026-09-27T20-24-21-155/main_board.kicad_pcb (2026-09-27, an earlier design)

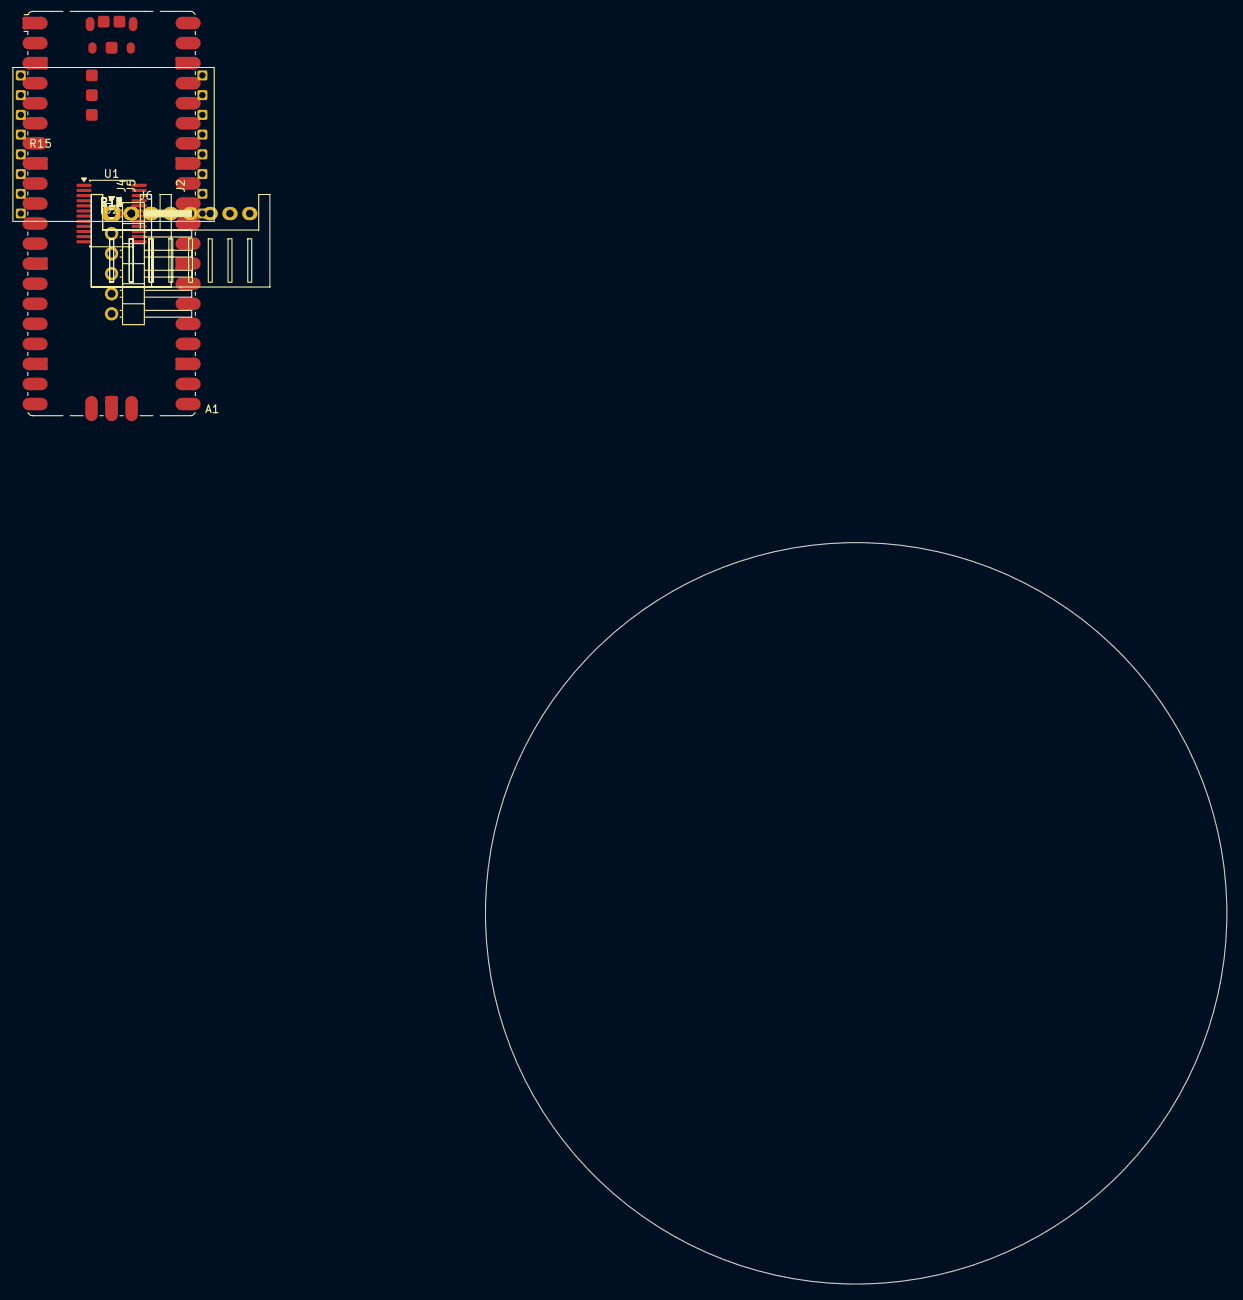
[picture p22: board pcb/main_board/_restore_backup_2026-09-27T20-24-21-155/main_board.kic… from above]

Board: 2 copper layers, 93.9 x 93.9 mm, 17 parts (0 on the bottom side), 23 nets, no tracks yet.

Parts:
A1: RaspberryPi_Pico; RaspberryPi_Pico_SMD
C11, C12, C13, C14, C15: 470pF; C_0603_1608Metric
J2: Conn_01x08; JST_XH_S8B-XH-A_1x08_P2.50mm_Horizontal
J4: Conn_01x02_Socket; JST_XH_S2B-XH-A_1x02_P2.50mm_Horizontal
J5: Conn_01x03_Socket; JST_XH_S3B-XH-A_1x03_P2.50mm_Horizontal
J6: Conn_01x06; PinHeader_1x06_P2.54mm_Horizontal
R11, R12, R13, R14, R15: 1k; R_0603_1608Metric
U1: TB6612FNG; SSOP-24_5.3x8.2mm_P0.65mm
U2: Wemos_battery_shield

Connections:
+3.3V: C14.1, J2.8, J6.5, R11.1, R12.1, R13.1
+5V: A1.39 (VSYS), C15.1, J5.2, J6.6, U1.20 (VCC)
/EI_CS: A1.12 (GPIO9), J2.4
/EI_DC: A1.11 (GPIO8), J2.3
/EI_MOSI: A1.10 (GPIO7), J2.6
/EI_RST: A1.6 (GPIO4), J2.2
/EI_SCLK: A1.9 (GPIO6), J2.5
/ENC_A: C13.1, J6.3, R13.2
/ENC_B: C12.1, J6.2, R12.2
/ENC_BUT: C11.1, J6.1, R11.2
/MOIST_AOUT: A1.31 (GPIO26_ADC0), J5.1
/MTR_AIN1: A1.17 (GPIO13), U1.21 (AIN1)
/MTR_AIN2: A1.19 (GPIO14), U1.22 (AIN2)
/MTR_PWM_A: A1.20 (GPIO15), U1.23 (PWMA)
/MTR_STBY: A1.16 (GPIO12), U1.19 (STBY)
/SLEEP_WAKE: A1.7 (GPIO5), R15.2
GND: A1.3 (GND), A1.8 (GND), A1.13 (GND), A1.18 (GND), A1.23 (GND), A1.28 (GND), A1.33 (AGND), A1.38 (GND), A1.D2 (GND), C11.2, C12.2, C13.2, C14.2, C15.2, J2.7, J4.2, J5.3, J6.4, R14.1, R15.1, U1.18 (GND)
unnamed: U1.1 (AO1), U1.2 (AO1)
unnamed: U1.5 (AO2), U1.6 (AO2)
unnamed: U1.11 (BO1), U1.12 (BO1)
unnamed: U1.7 (BO2), U1.8 (BO2)
unnamed: U1.3 (PGND1), U1.4 (PGND1)
unnamed: U1.9 (PGND2), U1.10 (PGND2)
