TheJoboReal/self_watering_pot/code/inc/defines.h

// Pins
#define ADC_PIN 26

// Dormant sleep mode
#define LOW_POWER_WAKE_GPIO 19
#define CLOCK_RST 16

// Pump
#define MOTOR_PWM_PIN 15
#define MOTOR_AIN2 14
#define MOTOR_AIN1 13
#define MOTOR_STBY 12

// Encoder
#define ENC_BUT 19
#define ENC_A 20
#define ENC_B 21

// EINK
#define EI_BUSY 1 
#define EI_RST 4
#define EI_SCLK 6
#define EI_MOSI 7
#define EI_DC 8
#define EI_CS 9
