TheJoboReal/self_watering_pot/code/inc/pump.h

#ifndef PUMP_H
#define PUMP_H

#include "defines.h"
#include "hardware/pwm.h"
#include "pico/stdlib.h"
#include "pico/time.h"

void init_motor() {
  // Direction
  gpio_init(MOTOR_AIN1);
  gpio_set_dir(MOTOR_AIN1, GPIO_OUT);

  gpio_init(MOTOR_AIN2);
  gpio_set_dir(MOTOR_AIN2, GPIO_OUT);

  // Standby
  gpio_init(MOTOR_STBY);
  gpio_set_dir(MOTOR_STBY, GPIO_OUT);

  // Set direction
  gpio_put(MOTOR_AIN1, 1);
  gpio_put(MOTOR_AIN2, 0);

  // Enable driver
  gpio_put(MOTOR_STBY, 1);

  // PWM
  gpio_set_function(MOTOR_PWM_PIN, GPIO_FUNC_PWM);

  uint slice = pwm_gpio_to_slice_num(MOTOR_PWM_PIN);

  pwm_config config = pwm_get_default_config();

  // 100 kHz PWM
  // 125 MHz / 1 / 1250 = 100 kHz
  pwm_config_set_clkdiv(&config, 1.0f);
  pwm_config_set_wrap(&config, 1249);

  // Initialize and start PWM
  pwm_init(slice, &config, true);

  // Initially off
  pwm_set_gpio_level(MOTOR_PWM_PIN, 0);
}

void run_motor(struct Soil *soil) {
  int milliseconds = soil->target_water_time;
  int pwm = soil->target_pwm;

  // Set direction
  gpio_put(MOTOR_AIN1, 1);
  gpio_put(MOTOR_AIN2, 0);

  // Enable driver
  gpio_put(MOTOR_STBY, 1);

  // PWM range is 0-1249
  pwm_set_gpio_level(MOTOR_PWM_PIN, pwm);

  // Run motor
  sleep_ms(milliseconds);

  // Motor OFF
  pwm_set_gpio_level(MOTOR_PWM_PIN, 0);
}

#endif
