TheJoboReal/self_watering_pot/code/inc/epd.h

// #include "../lib/e-Paper/EPD_2in13_V4.h"
// #define EPD_Display EPD_2in13_V4_Display

#include "../lib/e-Paper/EPD_2in9_V2.h"

// Constants
#define EPD_WIDTH           EPD_2IN9_V2_WIDTH
#define EPD_HEIGHT          EPD_2IN9_V2_HEIGHT

// Functions
#define EPD_Init            EPD_2IN9_V2_Init
#define EPD_Gray4_init      EPD_2IN9_V2_Gray4_Init
#define EPD_Clear           EPD_2IN9_V2_Clear
#define EPD_Display         EPD_2IN9_V2_Display
#define EPD_Display_Base    EPD_2IN9_V2_Display_Base
#define EPD_4GrayDisplay    EPD_2IN9_V2_4GrayDisplay
#define EPD_Display_Partial EPD_2IN9_V2_Display_Partial
#define EPD_Sleep           EPD_2IN9_V2_Sleep
