TheJoboReal/self_watering_pot/(commit log)

2026-04-12 added esp project
    [base.FCStd]
2026-08-06 changed to pico
2026-08-19 added motor branch
2026-08-28 added dormant and motor branch
2026-09-06 added 3d file
    [pot.FCStd]
2026-09-26 added pcb design
    [main_board.kicad_pcb, main_board.kicad_sch]
2026-09-26 added footprints
    [main_board.kicad_sch]
2026-09-26 added bin counter lib
    [main_board.kicad_sch]
2026-09-26 added wake pins
    [main_board.kicad_sch]
2026-09-27 added bin counter
    [main_board.kicad_pcb, main_board.kicad_sch]
2026-09-27 added bin counter foot
    [main_board.kicad_pcb, main_board.kicad_sch]
2026-09-27 added more footprints
    [main_board.kicad_pcb, main_board.kicad_sch]
2026-09-27 added foots to pcb
    [main_board.kicad_pcb]
2026-09-28 added gnd layer
    [main_board.kicad_pcb, main_board.kicad_sch]
2026-09-28 fixed bin counter
    [main_board.kicad_pcb, main_board.kicad_sch]
2026-09-28 pvcb review ready
    [main_board.kicad_pcb, main_board.kicad_sch]
2026-10-01 added button connector
    [main_board.kicad_pcb, main_board.kicad_sch]
2026-10-01 added mounting holes
    [main_board.kicad_pcb, main_board.kicad_sch]
2026-10-03 added cutout
    [main_board.kicad_pcb]
2026-10-03 addes pcb stp file
    [main_board.kicad_pcb, main_board.step]
2026-10-03 moved pcb cut
    [main_board.kicad_pcb, main_board.kicad_sch, main_board.step]
2026-10-03 added new step
    [main_board.step]
2026-10-03 chaned cut more
    [main_board.kicad_pcb, main_board.step]
2026-10-04 fixed stupid stuff
    [main_board.kicad_pcb, main_board.kicad_sch]
2026-10-04 added holes and exported step
    [main_board.kicad_pcb, main_board.kicad_sch, main_board.step]
2026-10-05 fixed all errors
    [main_board.kicad_pcb]
2026-10-07 added fabrication files for kicad
    [main_board-B_Cu.gbr, main_board-B_Mask.gbr, main_board-B_Paste.gbr, main_board-B_Silkscreen.gbr, main_board-Edge_Cuts.gbr, main_board-F_Cu.gbr, main_board-F_Mask.gbr, main_board-F_Paste.gbr]
2026-10-09 added inventor files
    [2.9inch e-Paper Module bw v2.STEP, 2.9inch e-Paper Module bw v2.ipt, Assembly_Flaura.0077.iam, Assembly_Flaura.iam, Battery_Mount.ipt, Battery_Mount.stl, Dummy_Capacitive_Soil_Sensor.ipt, Dummy_Circuit_Board.ipt]
2026-10-09 moved eink to side
    [Assembly_Flaura.0077.iam, Assembly_Flaura.0080.iam, Assembly_Flaura.iam, Bottom_plate.0005.ipt, Housing_Inner_Outer.0021.ipt, Housing_Inner_Outer.0026.ipt, Housing_Inner_Outer.ipt, Housing_Outer.stl]
2026-10-10 fixed zero thickness walls
    [Housing_Inner_Outer.0026.ipt, Housing_Inner_Outer.0029.ipt, Housing_Inner_Outer.ipt, Housing_Outer.stl]
2026-10-26 Squash merge pcb_pins_update into main
2026-10-27 fixed shell thickness
    [Housing_Inner_Outer.0029.ipt, Housing_Inner_Outer.0031.ipt, Housing_Inner_Outer.ipt, Housing_Outer.stl, bottom_plate.stl]
2026-10-28 added sensor print
2026-10-28 updated to pico board1
2026-10-28 added eink branch
    [Housing_Inner_Outer.0029.ipt]
2026-10-28 fixed 4060 and added 3.3 vcc
    [main_board.kicad_pcb, main_board.kicad_sch]
2026-10-28 fixed wires
    [main_board.kicad_pcb, main_board.kicad_sch]
2026-11-06 added pump mount and pump holes
    [Assembly_Flaura.0080.iam, Assembly_Flaura.0084.iam, Assembly_Flaura.iam, Bottom_plate.0005.ipt, Bottom_plate.0008.ipt, Housing_Bottom.0034.ipt, Housing_Bottom.0038.ipt, Housing_Bottom.ipt]
